shenguangmu/gesture_recognition_system/report/README.md

# 设计报告

> 本目录是赛题 §3.3.5.3「设计报告」的存放位置。

## 索引

| 文件 | 内容 | 状态 |
|---|---|---|
| [`design.md`](design.md) | **设计报告正文**（七节） | ✅ 除 §4.4 外完成 |
| [`llm-collaboration.md`](llm-collaboration.md) | **大模型协作记录**（含自我纠错轨迹） | ✅ 完成 |
| [`../src_hls/optimization-report.md`](../src_hls/optimization-report.md) | **优化对照实验 + 时序分析**（§4 的详细数据） | ✅ 完成 |

**不在本目录、但同属提交物的**：

| 内容 | 位置 |
|---|---|
| 技能包（赛题 §3.3.5.2） | [`../skill/README.md`](../skill/README.md) |
| 综合与实现报告（§3.3.5.1） | [`../vivado/build-report.md`](../vivado/build-report.md) |
| 复现说明 | 根 [`README.md`](../README.md) 的「从零构建完整工程」 |
| 目录对照说明（§3.3.5.4） | [`../docs/README.md`](../docs/README.md) |

---

## 各节状态

| 节 | 内容 | 状态 |
|---|---|---|
| ① 选题背景与创新点 | 三个创新点 + 前人工作（**含 3 篇核验过 DOI 的文献**） | ✅ |
| ② 设计原理与功能框图 | 系统总览、两条数据通路、时钟域 | ✅ |
| ③ 软硬件划分与接口 | 划分判据、唯一接口契约、96×96 重排理由 | ✅ |
| ④ 优化过程 | 实测数据 + **一次失败的优化（有数据）** + **时序分析（§4.5）** + 待补基线 | ⚠ **§4.4 缺口** |
| ⑤ 大模型协作记录 | → `llm-collaboration.md` | ✅ |
| ⑥ 技能包提炼过程 | → `../skill/README.md` | ✅ |
| ⑦ 复现说明 | → 根 `README.md` | ✅ |

---

## ⏳ 待办清单（**板已到，按此执行**）

> **影响评分的缺口只剩一个：加速比。**
> 赛题 §3.3.5.5 把"性能与资源**优化效果**"列为 **20 分**，
> §3.3.4 要求"给出**与基线的对比**"。
>
> 2026-09-18 的 B1 工作把 §4 从"单点数据"推进到了
> **"单点数据 + 一组严谨的负结果对照实验"**，
> 但**加速比这一半仍未拿到** —— 它必须在 PYNQ 的
> Cortex-A9 上测，PC 上测的数（Ryzen 9 8940HX）代际不同，不能用。

**20 分项现在的完成度**（分开说，别含糊）：

| 赛题要的 | 状态 |
|---|---|
| 资源/时序实测数据 | ✅ 有（`build-report.md`，与 `utilization.rpt` 逐项核对） |
| 优化尝试与结论 | ✅ 有（**4 组对照实验 + 探针**，且区分了"找到根因"与"能改"） |
| **上板实测性能** | ✅ **有（2026-09-21）**：预处理单帧 **≈5 ms**，11/11 全过 |
| **与基线的加速对比** | ❌ **没有 —— 唯一的真缺口，见 P1。板已到，只差跑一次** |

> ⚠ **本次上板顺带更正了一个报告里的错数**：§4.4 原写
> `crop_scale` = **20.74 ms**、整链 **21.4 ms**，那是把
> `LOOP_TRIPCOUNT` 的**循环上界**当成了实际执行拍数。
> 实为 **3.07 ms**，整链估算 ≈3.7 ms —— 与实测 5 ms 吻合。
> 详见 `design.md` §4.4 的更正框。

### P1 · PS 侧基线（**唯一能补齐 20 分项的动作**）

> ✅ **板已到、overlay 已能加载、串口与网络都已打通** ——
> 这件事现在**只需要在板上跑一次脚本**，没有任何前置阻塞。

| 步骤 | 做法 |
|---|---|
| 1 | 把 [`../host/bench_ps_baseline.py`](../host/bench_ps_baseline.py) 拷到 PYNQ（`scp` 在 **PC** 上跑） |
| 2 | 板上跑：`sudo -E /usr/local/share/pynq-venv/bin/python3 bench_ps_baseline.py --json ps.json` |
| 3 | 与 PL 侧延迟对比 → **加速比** |

> **PL 侧的口径是现成的**：`design.md` §4.4 的上板实测 **≈5 ms/帧**。
> ⚠ 对比时要说清这一项**不含摄像头采集**（输入来自 DDR 测试图），
> 以及它是 PL 侧单次预处理延迟，不是端到端帧率。

**为什么是唯一的**：它直接回答赛题的核心问题"**为什么用 FPGA**"。
其余各项（资源、时序、优化尝试）**都已经做到能做的最好**了。

**可对照的先例**：CANDAR 2020 在 **PYNQ-Z1** 上测得
"**相比同一块板的 PYNQ ARM CPU 加速 22×**"（见 `design.md` §1.4②）。
本作品测出的数可与 22× 对照。

> ⚠ **主机 CPU 的数不能直接写进报告**。该脚本在 PC 上跑出约 3.8 ms/帧，
> 但那是 Ryzen 9 8940HX，**不是 Cortex-A9**，差着代际。
> 脚本里已标注它是"主机参考值，非 PS 基线"。

> ⚠ **PL 侧那一半要取对口径**。`design.md` §4.4 的**逐级**表是
> **从 instance 表加总的估算**（顶层 `DATAFLOW` 的 latency 在 csynth 里
> 显示为 `?`，各 stage 重叠，HLS 给不出静态总延迟）。
> **权威数字是上板实测的 ≈5 ms/帧**，拿估算值去除以 PS 基线会被挑。
>
> ⚠⚠ 该表**曾经把 `crop_scale` 记成 20.74 ms / 整链 21.4 ms** ——
> 那是把 `LOOP_TRIPCOUNT` 的**循环上界**当成了实际拍数。
> **2026-09-21 上板实测更正为 3.07 ms / 整链 ≈3.7 ms**（与实测 5 ms 吻合）。
> **比加速比之前先确认这张表是当前版本**，否则会高估 PL 侧延迟一个数量级。

### P2 · 上板实测输出（**赛题硬性要求**）—— ⚠ **部分完成**

| 步骤 | 产出 | 状态 |
|---|---|---|
| 按 [`board-bringup-guide.md`](../docs/board-bringup-guide.md) 走分级验证 | — | ✅ **②③ 已过（11/11）**；④~⑧ 未通 |
| 截下 Jupyter 里出的图 | **实测输出 + 与参考结果的比对** | ✅ **已做（2026-09-23，方案 A 静态图）**：三次不同输入 / 三种 ROI，板上输出与 golden **逐字节一致**（各 0/9216）。见 [`board-test-log-2026-09-23.md`](../docs/board-test-log-2026-09-23.md) §9 |
| 测实际帧率 / DMA 吞吐 / 预处理单帧耗时 | 补进 `design.md` **§4.4** | ⚠ **部分**：预处理单帧 ≈5 ms 已测；**端到端帧率未测** |

> 赛题 §3.3.3.2："作品须**在板上跑通并提供实测输出**"。
>
> ✅ **"板上跑通"与"实测输出"两项均已达成**（2026-09-23）：
> 预处理链 11/11，且**静态图通路（方案 A）的板上输出与 golden 逐字节一致**。
>
> ⚠ **本节原先写"实测输出要等摄像头通路打通"—— 那是错的。**
> 赛题 §3.3 **没有要求必须用 DVP 摄像头**（"应用方向不限、实现方式不作限定"），
> 把图片直接写进 DDR 输入缓冲即可满足「在板上跑通并提供实测输出」。
> **摄像头是加分项，不是提交物的前置条件。**
>
> 摄像头通路本身仍未通（SCCB `cfg_error=1`），排查进展见
> [`../docs/board-test-log-2026-09-22.md`](../docs/board-test-log-2026-09-22.md) §六。
>
> ⚠ **本项原先写的是"替换 `design.md` §3.2 的『按设计推算』栏"——
> 那个引用是错的**：§3.2 是**接口契约**（buffer 位置/格式/尺寸/握手寄存器），
> 里面根本没有吞吐量推算。吞吐相关的数据在 **§4.4**。
> 已更正。

### P3 · HLS 优化前后对比 ✅ **已完成（2026-09-18）**

结果见 [`../src_hls/optimization-report.md`](../src_hls/optimization-report.md)。
**结论是负结果，但数据完整**：

- 探针证明 DSP 的根因（腐蚀流水线的索引算术：71 → 15）
- 但**改不掉**：换编译期步长无效、手写展开反而更差（71 → 86）
- **顺带查出 WNS `+0.265` 不属于本设计**，是 AMD `v_tc` IP 的
- **顺带核对出 3 处凭记忆写错的资源数字**（LUT `13,184`→`13,144`、
  Fmax `137`→`143.31 MHz`），已更正
- 工具用上了：[`../skill/pynq/golden_compare.py`](../skill/pynq/golden_compare.py)，
  同时**发现并修掉了它的一个静默失败**（见 `skill/pynq/README.md`）

> ⚠ **DSP 的大头在 `morph_stage`（56 个），不在 `thresh_stage`（2 个）。**
> 项目里曾有四处写反。
>
> ⚠ **旧警告已作废**：这里原先写"唯一能降 DSP 的改法会让 II 从 1 退化成 2"。
> 经 2026-09-18 实测，**从未出现过 II=2**（全程 II=1），
> 而能降 DSP 的写法代价是**资源反而增加**（71→86）。详见 `optimization-report.md`。

### P4 · 上电前的硬件复核 —— ⚠ **引脚复核仍未做**

| 项 | 为什么 | 状态 |
|---|---|---|
| **引脚万用表复核** | XDC 映射是**推理**的（原理图"镜像编号"），**插错会 3V3/GND 反接烧板**（步骤见 `board-bringup-guide.md` §2.2） | ❌ **仍未做**（上电前应做但跳过了）—— 见 `board-bringup-guide.md` §2.2 |
| 短路检查 | 3V3 对 GND 的电阻 | ✅ 已做 |
| **OV5640 出图验证** | 配置表已换 250 条真表 | ⚠ **上板确认事务发出但无 ACK**（`cfg_error=1`），未出图 |

> ⚠⚠ **引脚复核与本项目当前故障直接相关**：摄像头 SDA/SCL 的引脚映射是
> 按"镜像编号"**推理**的，从没实测过。而 ILA 抓到的 `sccb_0/cfg_error=1`
> （配置无 ACK）正是"接线错"的典型症状之一。
> **它同时也是唯一有烧板风险的一项**，应尽快补做。
