shenguangmu/gesture_recognition_system/docs/images/roi_compare.png

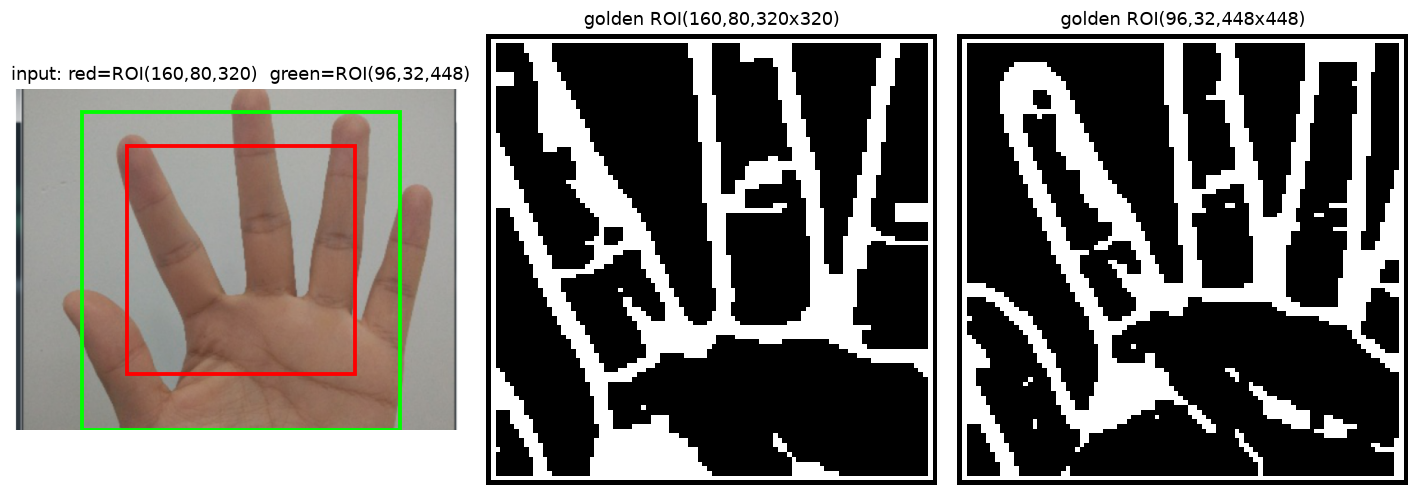
docs/images/roi_compare.png
