shenguangmu/gesture_recognition_system/docs/images/board-test-input-2026-09-23.png

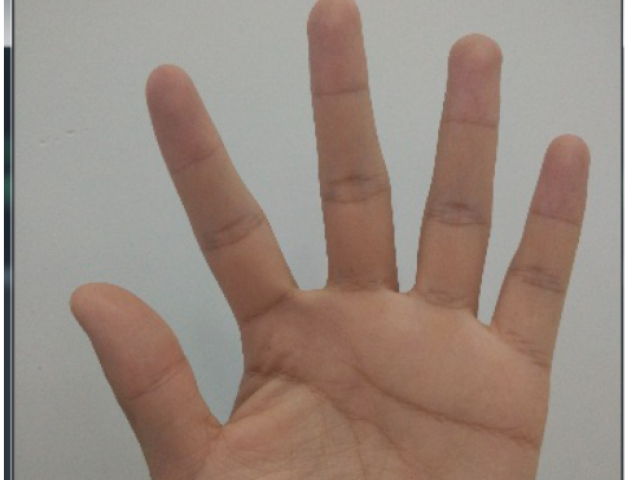
docs/images/board-test-input-2026-09-23.png
