shenguangmu/gesture_recognition_system/(commit log)

2026-09-20 修一个被截断的函数 + UTF-8 兜底去重，然后打板前锚点 tag
    ## 修的是我自己几轮前写的 bug（**它在 HEAD 里已经躺了多个提交**）
    `host/bringup_check.py` 的 `step2_ddr()` 被**从中间截断**：
    def _fail(): # 第 101 行 —— 插在了 step2_ddr 中间
    return False
    import numpy as np # ← 后面全是死代码
    buf = allocate(...) # step2_ddr 的剩余部分，永远执行不到
    我当时把 `_fail()` 的定义插进了 `step2_ddr()` 里头。
    **为什么一直没暴露**：测试跑的是 `--step 2`，在无板环境下
    `from pynq import allocate` 必然失败，走早退分支 `return _fail()`
    ——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
    [bringup_check.py, pynq_serial.py, test_overlay_offline.py, test_pynq_serial.py]
2026-09-20 修 pyserial 的模块级硬退出 + 让"跳过"可见（CI 抓到的两个问题）
    ## ① `pynq_serial.py` 在 import 时就 sys.exit(2)
    CI 首次跑新加的 job 就红了，退出码 2：
    `需要 pyserial： pip install --user pyserial`
    后果不只是 CI：**连它自己的离线自检都跑不起来** ——
    `test_pynq_serial.py` import 本模块时就被那个 exit 带走，
    而离线自检要测的 `_pick_ips` 是**纯正则，根本不需要 pyserial**。
    改成"用到串口时才报错"（`_need_serial()`）：
    库的部分可以无依赖地 import 和测试。
    ## ② 测试**静默跳过**，汇总照样报 PASSED ← 更值得记的一条
    给跳过加了计数器之后，汇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
    [pynq_serial.py, test_pynq_serial.py]
2026-09-20 修 CI 检查自身的误报："跳过"二字命中了小节标题
    上一提交加的"不许有跳过"检查：
    if grep -q '跳过' /tmp/serial.log; then exit 1; fi
    结果 [2] 的小节标题 **「串口筛选（跳过蓝牙幻影口）」** 把它命中了 ——
    日志明明是 `PYNQ_SERIAL TESTS PASSED (10 项)`，却报了
    `::error::有测试项被跳过 —— 覆盖不完整`。
    **这是我这一轮第三次被自己新加的检查绊倒**（前两次是
    正则误伤 bringup_check.py、以及跳过分支没计数）。
    规律很清楚：**"检查"本身也是代码，也会错，而且错了更难发现 ——
    因为它在报错，看起来像是在工作。**
    改法：
    - 跳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
    [test_pynq_serial.py]
2026-09-20 手册加 §6.5「现象 → 先查哪」——把脚本里的排查提示系统化补进文档
    ## 动机
    §5 的每一步都写了「**应该看到什么**」，但上板时人手里只有现象、
    没有结论。而 `host/bringup_check.py` 的失败分支里其实已经写好了
    一堆排查提示 —— **那些只活在脚本里，文档里没有**。
    对齐了两边，缺口有 3 类共 8 条：
    | 脚本里查了 | 手册原来有没有 |
    |---|---|
    | 回读是 248 而非 -8 | ❌ |
    | 卡在等 ap_done 超时（3 条） | ❌ |
    | 输出**全黑**（3 条） | ❌ |
    | 输出**全白**（2 条） | ❌ |
    | 串口卡 Loading kernel | ✅（§9） |
    | io_xclk / io_pclk 无波形 | ✅（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
2026-09-21 修 AXI DMA 长度位宽 14→24，解决上板 ③ 卡死（首次上板实测）
    根因：bd_video.tcl 例化两个 AXI DMA 时**没设 C_SG_LENGTH_WIDTH**，
    IP 用默认值 14 位 → 单次传输上限 2^14-1 = 16383 字节。
    而输入帧是 614400 字节（640x480 RGB565），是上限的 37 倍
    → DMA 只搬了前 16 KB 就置 IOC_Irq（"传输完成"是真的，
    只是它认为的"全部"只有 16 KB）
    → crop_scale 永远读不满输入 → 整条 DATAFLOW 链停摆
    → dst 不吐 → ap_done 永不置位。
    确诊证据：写 LENGTH 614400 → 读回 8192
    （= 614400 mod 16384，完全吻合；写一组值验证了 123456→8768、
    100000→1696、65536→0，规律一致）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
2026-09-22 把 2026-09-21 首次上板实测的结论同步到全部文档
    上一轮（a4eabe6）只记了代码修复与一份实测记录，各 README / 报告
    仍停在"板子未到"的状态。本次按 skill/self-correction 模式 4
    （按完备范围检查，不按记忆范围）枚举全部 git ls-files '*.md'，
    逐一核对并同步。
    同步内容：
    - 板级状态：②③ 通过（11/11，单帧 ≈5ms）；④~⑧ 未通（SCCB cfg_error=1）
    - 上板命令改为正确的 sudo -E + 解释器全路径形式
    - 坑计数 19→20（vivado/README 新增坑 20 = pitfalls P10 = DMA 长度位宽）
    - host/README 补全漏列的 5 个上板诊断脚本
    - skill/README 的 pitfalls 计数 8→10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
2026-09-22 修 MMCM 参数失效 + 引脚映射全错（第二轮上板实测）
    摄像头通路仍未打通，但查清并修复了两个独立根因，
    两者都是"综合能过、只有上板才暴露"的类型。
    ## 根因一：MMCM 参数被静默忽略（XCLK 因此不出）
    bd_video.tcl 里设的 MMCM_CLKFBOUT_MULT_F 等三个参数被丢弃：
    WARNING: [IP_Flow 19-3374] An attempt to modify the value of
    disabled parameter 'MMCM_CLKFBOUT_MULT_F' ... has been ignored
    只给 WARNING 不给 ERROR，工具照用自己的求解器结果（自选 VCO≈1005MHz，
    贴着 -1 速度等级上限）。
    解药是 CONFIG.OVERRIDE_MMCM {true} —— 不是 PRIMITIVE {MMCM}，
    也不是 USE_FREQ_SYN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
    [camera_probe.py, vdma_bypass_test.py, video_io.xdc]
2026-09-22 建立静态图输入通路（方案A）+ 发现 crop_scale 整数块平均缺陷
    摄像头仍未通，但改走"静态图喂 DDR"后主线跑通，
    并因此暴露出一个此前从未触发的 PL 算法 bug。
    ## 方案 A：图片直接写进 DDR，完全跳过摄像头
    读过赛题原文（AMD.pdf §3.3 自主选题赛道·初级组）：
    - "应用方向不限"、"实现方式不作限定"
    - 硬性要求只有"板上跑通并提供实测输出"+"与基线对比"
    通篇没有"必须用 DVP 摄像头"的要求。备赛分析报告也把 USB 摄像头
    列为可选图像源。故方案 A 在规则上完全站得住。
    新增 host/capture_frame.py：图片/USB摄像头 → 640×480 RGB565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
    [capture_frame.py]
2026-09-23 修 crop_scale 固定步长缺陷：改按比例分配
    根因：旧实现 step = ceil(roi_w/96)，roi_w=320 时 step=4 恰好整除
    → 每行只吐 320/4 = 80 个输出 → 只填 80×80=6400，剩 2816 个走补零
    → 输出右下角一大片恒为零。这正是 2026-09-22 "静态图对拍 golden
    对不上"的根因，与摄像头无关。
    ⚠ 为什么藏了这么久：HLS / C++ golden / Python golden 三份实现
    **用了同一套错误逻辑**，csim 是自比对 → 两边一起错 → 永远"通过"。
    N 份实现 ≠ N 份独立验证，抄语义不算对拍。
    修法：按比例分配。第 j 个输出覆盖源 [j*roi_w/96, (j+1)*roi_w/96)
    （整除）。相邻区间共用同一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
2026-09-23 修 GesturePipeline 构造：Overlay() 必须显式传 bitfile
    板子上第一次调用就炸：
    TypeError: Overlay.__init__() missing 1 required positional
    argument: 'bitfile_name'
    根因：PYNQ 3.x 的签名是
    Overlay(bitfile_name, dtbo=None, download=True, ...)
    bitfile_name 是**必填位置参数**，没有默认值；而 notebook 里
    `Overlay()` 能自动找同名文件是 PYNQ 的语法糖，**类构造器没有这个行为**。
    我们写的 `Overlay(**kw)` 传不出 bitfile_name。
    修法：bitfile 为 None 时自己解析路径（新增 _find_bitfile()），
    再显式传给 Overlay。查找优先约定名 gesture_system.bit，
    退化到"目录里唯一的 .bit"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
    [gesture_overlay.py, test_overlay_offline.py]
2026-09-23 修 crop_scale 跳过 ROI 外行时不读流 → roi_y 完全失效
    上板实测（2026-09-23）：寄存器 roi_y 读回 80/160 均正确，
    但硬件行为恒等于 roi_y=0：
    配 roi_y=80 与 roi_y=160 → 输出**逐字节相同**
    且都 == golden(roi_y=0)
    根因：crop_scale 的行循环
    for (y) {
    if (!(y>=roi_y && y<roi_y+roi_h)) continue; // ← 整行跳过
    for (x) { w_in = src.read(); ... } // ← 流在这里读
    }
    跳过的行**一个像素都没从流里读走** → 上游数据没被消费 →
    硬件把**帧的前 roi_y 行**当成了 ROI 首行。
    （roi_x 不走这条路 —— x 循环不跳过、in_roi 只做判断、照常 rea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
2026-09-23 更新上板日志：追加 roi_y 失效 bug 的根因与验证
2026-09-23 上板日志 §2 标注：最终用 §8.5 那版（roi_y 修复后）
2026-09-23 上板日志：真实照片 + 合成图三次测试全部逐字节一致
    - §9 记录用真实照片（力手）走完整静态图通路，两种 ROI 均与 golden 100% 一致
    - §9.3 ROI 选点经验：roi_x=160 会把拇指切出框外，roi_x 需 <=100 才纳入五指
    - §9.4/§9.5 新增原生 640x480 合成手势图全幅测试，三次测试汇总
    - 新增 docs/images/ 对比图 4 张
    - 新增 host/run_static_frame_on_board.py（板端跑帧 + 对拍脚本）
2026-09-23 修正对比图：测试1 的 golden 用错了文件
    生成 all_tests_compare.png 时，通用名 golden.bin 已被
    合成图的全幅 golden 覆盖（cp golden_448.bin golden.bin 后又
    cp synth_golden.bin golden.bin），导致测试 1 那一行拿
    "力手 160,80 的输出" 去比 "合成图 0,0 的 golden"，
    图上误显示 FAIL 3594。
    实际上该次板上实测是 0/9216 一致。现已用单独命名的文件
    （force_r1_golden.bin / force_r2_golden.bin / synth_golden.bin）
    重新生成，并新增「差异图」一列（全黑=完全一致）便于自验。
    三者逐一核对：
    测试1 板上2677 / golden2677 差异 0
    测试2 板上2806 / golden2806 差异 0
    测试3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
2026-09-23 README 补一键重建 + 今日四坑；rebuild_all.sh 加僵死进程防呆
    README：
    - 新增「⭐ 推荐：一键重建」段，说明为什么不能手敲那两条命令
    （IP 版本号永远是 1.0 → 取了旧 IP 也不报错，只会默默用错实现）
    - 补 .hwh 必须改名成 gesture_system.hwh 的警告
    （名字不一致时 PYNQ 不报"找不到 hwh"，而是只认出 default 一个 IP）
    - 「最值钱的坑」表加今日四条：跳过 ROI 外行不读流、IP 版本号恒 1.0、
    Overlay 构造器要显式传 bitfile、ILA 会让正式比特流 hold 违例
    - 新增「这些坑背后的同一个模式」小节：一天内三次"测试全绿却有缺陷"，
    分别因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
2026-09-23 同步各 README 到 2026-09-23 的实际状态
    今日两个真缺陷已修，多处 README 的描述过期：
    src_hls/README.md
    - 顶部清单与验证表：csim 用例 5 → **7**、cosim 6/6 → **10/10**
    - 板级输出 vs golden：❌ 对不上 → ✅ **逐字节一致**（三次实测各 0/9216）
    - 原「⚠⚠ 已知 bug：填不满 96」→ **✅ 已修**，并补上第二个缺陷
    （跳过 ROI 外行不读流 → roi_y 失效）
    - ⚠ 删掉一条**已证伪的判断**：本文件曾写"Python golden 走浮点比例缩放、
    与整数块平均语义本就不同"—— 实际它当时也照抄了固定步长，
    这正是三份实现一起错、csim 永远通过的原因
    -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
2026-09-23 更新 LUT 资源数字到 2026-09-23 实测（21% → 45.94%）
    crop_scale 改按比例分配后，需要 acc[96] 累加器 + ARRAY_PARTITION
    complete 才能保住主循环 II=1，LUT/FF 接近翻倍。**是设计变更，不是测量误差。**
    源头（vivado/build-report.md，赛题 §3.3.5.1 要求提交的那份）：
    Slice LUTs 11,255 (21.16%) → **24,442 (45.94%)**
    Slice Registers 14,810 (13.92%) → **30,692 (28.85%)**
    WNS +0.265 → **+0.199**（仍属 v_tc 内部，非本设计余量）
    BRAM 18.21% / DSP 27.73% / IOB 28.00% —— **三项不变**
    新增「LUT/FF 翻倍是设计变更」小节，附新旧对照与取舍理由、
    以及回退方式（去掉 acc[] 的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
2026-09-23 README/文档补状态：静态图通路已验证，不再是"卡在摄像头"
    用户的观察是对的：上一轮我只查了**数字**，没查**状态描述**，
    而后者误导性更强。系统性重查后修掉这些：
    根 README.md（总入口，误导性最强）
    - 进度表标题：2026-09-22 → **2026-09-23**
    - 输出 vs golden：❌"对不上…**明天修**" → ✅✅ **逐字节一致**（三次实测）
    - 静态图喂入：补"与 golden 逐字节一致"
    - 时序：WNS +0.517 → **+0.199**（2026-09-23）
    - 驱动自检 24/24 → **26/26**
    - 上板必读：补 09-23 日志；WNS 波动值补 +0.199
    - 结论段：不再说"下一步用 ILA 探针"，改为**⚠ 别用 ILA*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
2026-09-23 交付第一步：修正给 PS 侧的接口契约 + 备好样例数据
    ⚠⚠ 修掉一个**会直接坑死 PS 侧**的错误契约：
    docs/architecture-contract.md §3.2 原先描述了一套"握手寄存器"
    （INPUT_ADDR / FRAME_SEQ / frame_ready / CTRL.capture_start）——
    **那套寄存器从未实现**，BD 与 RTL 里 grep 只有一句注释。
    照那份假契约写代码必然跑不通。
    §3.2 改写为**已实现的真实接口**：
    - 三个 IP 及其 AXI-Lite 基地址（并警告别硬编码，重综合后会变）
    - gesture_preproc 全部 16 个寄存器偏移（与 HLS 官方头逐条核对过）
    - ⚠ 状态位在 CTRL(0x00) bit1，**不在 0x04**（那是 GIE）
    - ⚠ thre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
2026-09-23 samples: 补 thresh_mode 二值/灰度对比 —— 决定 CNN 能学什么
2026-09-23 samples: 修掉文档里被吃掉的续行符
2026-09-23 新增给 PS/CNN 侧的交付说明 docs/pl-to-ps-handoff.md
    一份可独立阅读、可直接发给对方的文档。核心信息：
    **PS 侧现在就能开始，大部分工作不需要板子**
    - 数据格式：96×96 uint8 行优先，9216 B，4 字节对齐，不归一化
    - 批量造数据：host/gesture_golden.py 可 import，
    输出与硬件**逐位一致**（三方对齐链：板上 == C++ golden == Python golden）
    - samples/ 里有硬件实测对过的 golden（md5 与板上输出相同）
    **⚠ 一处必须先在 PS 侧拍板的事：thresh_mode**
    1（当前默认）→ 二值（只有 0/255），对光照天然鲁棒
    0 → 灰度（99 种取值），保留边缘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
2026-09-23 新增 host/usb_camera_run.py —— USB(UVC) 摄像头 → PL 预处理链
    USB 摄像头是另一条输入路径，绕开全部 DVP 硬件：
    USB: 摄像头 --USB--> PS CPU --> DDR --> PL(dma_in) --> 预处理链 --> DDR
    ↑ 从"写进 DDR"起，与方案 A 完全相同
    **PL 侧一行都不用改** —— 这正是把边界定成「DDR 里一块 640×480 RGB565」的价值。
    ⚠⚠ 脚本里最关键的一行是强制 MJPEG：
    PYNQ-Z2 是 USB2。720p 下 YUYV 需 ~55 MB/s（超 USB2 实际带宽），
    MJPEG 只用 3~6 MB/s。不设 FOURCC 时 UVC 默认常协商成 YUYV →
    **分辨率被悄悄降级或帧率掉到个位数，且不报任何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
2026-09-23 host/README 索引补 usb_camera_run.py
2026-09-23 新增 host/run.py —— 板上日常操作的一键入口
    把上电后要敲的那一长串（chdir / import / 加载 overlay / 配 ROI /
    读 bin / flush / run_once / show）收敛成一句：
    %run /home/xilinx/run.py
    设计取向：**只做基本操作和输出，不做断言**。
    判定/校验交给 bringup_check.py；这个是干活用的 —— 跑一次、看一眼、走人。
    交互式菜单列出当前可用的输入（按修改时间倒序）：
    · *.bin（已有的测试帧）
    · 图片（jpg/png/...，自动缩放 + 转 RGB565）
    · USB 摄像头（货到即可用）
    · 手动输入路径
    ⚠ 刻意不用 argparse：`%run x.py --frames 3` 时 IPython 会把参数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
2026-09-23 板上首跑 run.py 踩的两个问题：菜单混入输出文件 / 中文标题豆腐块
    都是 2026-09-23 板上实跑发现的。
    run.py —— 菜单按**大小**过滤
    /home/xilinx/ 下同时躺着两类 .bin，后缀一样、名字分不出：
    输入帧 640x480 RGB565 = 614400 字节
    输出结果 96x96 灰度 = 9216 字节
    而**输出文件的数量是输入的 6 倍**，按修改时间倒序排，
    菜单第一项必然是输出 —— 也就是**任何人第一次用都会踩**。
    实测选中 hw_synth.bin（9216 B）当输入，以"字节数不对"结束。
    改为按大小分流，并明确列出"以下不当作输入（尺寸不符）"及原因 ——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
    [gesture_overlay.py, run.py]
2026-09-23 纳入板上调试脚本：ap_done_probe / ap_start_probe / dma_diag
    这三个一直只存在于板上，仓库里没有 —— 清理板子前先把它们收进版本库，
    否则里面的经验会随文件一起丢。都是 2026-09-21 排查 ap_done 超时时留下的：
    - `dma_diag.py` —— 查 dma_in/dma_out 卡在哪。**v2 修正了 v1 的两个错误**：
    ① v1 把 DMASR 的 bit1(IDLE) 当成 IOC → "IDLE=0" 被误读成"在忙"
    ② v1 在轮询循环里边读 CTRL 边判 → 读到的 0 不能证明"没跑完"
    v2 改成：轮询时**不读 CTRL**，只读 DMASR；循环后再取一次快照
    - `ap_done_probe.py` —— 因为 v1/v2 都在"怎么解读 DMA 状态寄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
    [ap_done_probe.py, ap_start_probe.py, dma_diag.py]
2026-09-23 host/README：补三个诊断脚本 + 清理板子的检查清单
    一、诊断脚本表更新
    之前写着「`ap_done_probe.py`、`dma_diag.py` 没进仓库，
    要复现那一步得照实测记录重写」—— **现在有了**，而且漏说了 `ap_start_probe.py`。
    顺带把这三个的来历说清楚 —— 它们是"反过来做"的产物：
    `dma_diag` 的 v1/v2 **都在"怎么解读 DMA 状态寄存器"上出错**
    （v1 把 DMASR 的 bit1(IDLE) 当成 IOC；v2 修正为轮询时不读 CTRL）
    `ap_done_probe` 就是因为这两版都不可信才写的 ——
    **干脆不解读状态位**，只测两个硬事实（ap_done 何时置位 / DMA 搬没搬）
    >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
2026-09-24 docs(hls): 更正 gesture_preproc.h 的失效说明与 6 个零实现声明
    纯注释改动，无语义变化。csim 7/7 通过（含两个历史 bug 的回归用例）。
    - 文件头：共享清单里的 `sw/gesture_driver.h` **在本仓库从未存在**
    （实际是 sw/preproc_driver.h，且它并不 include 本头文件，只同步常量）。
    "四处共享"改为三处并说明 PS 侧是常量同步关系而非 include。
    - 文件头：处理链图原画成 "rgb2gray → ... → morph_close → roi_extract"，
    与实现**方向相反**。实际是 crop_scale 打头、几何处理在最前
    （见 gesture_preproc.cpp 文件头「处理链」一节：省 33 倍算力的关键设计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
    [gesture_preproc.cpp, gesture_preproc.h]
2026-09-24 feat(host): 新增 auto_roi.py —— 自动跟随手部的 ROI 估算（方案 B）
    背景：`gesture_preproc` 的 ROI 是 PS 写死的四个常量，PL 完全不知道手在哪。
    2026-09-23 实测：ROI=(160,80)320x320 把拇指切出框外，输出只剩四根手指。
    本模块在 ap_start 之前，从 DDR 整帧估算手的位置，再写 ROI 寄存器。
    方案 B（用户选定）：尺寸恒定 448x448，中心跟手，钳到画面内，
    前景太少则回退居中。尺寸恒定是为了保持 crop_scale 缩放比不变、
    Sobel 的 gain=256 标定一直有效。
    检测算法：前景 = |Y - bg| > 25，bg 取画面边框像素的中位数。
    - 用**绝对偏离**而非 "Y > 阈值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
2026-09-24 feat(sccb)+docs: SCCB 失败定位、修正假握手表、修正"局部均值"注释
    三件事，各自独立验证。
    ═══ ① SCCB 失败定位（rtl/sccb_master.v + tb）═══
    摄像头调试卡在 cfg_error=1，但**无法回答最关键的二分问题**：
    第 1 条就 NACK → 总线层（上拉/接线/器件地址/电源）
    中间某条 NACK → 该条寄存器值不被接受
    两者排查方向完全相反，而在改动前它们**长得一模一样**：
    cfg_error=1、done_cnt=250、cfg_done=1。
    （done_cnt 是**事务计数**，遇到 NACK 也照样递增 —— 所以
    "全都成功"和"全都失败"在旧探针上无法区分。）
    新增两个输出端口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
    [gesture_preproc.h, sccb_master.v, tb_sccb_master.v]
2026-09-25 build: 重建 —— xsa 纳入 9/24 的 SCCB 诊断探针，比特流可上板
    背景：上一次重建在 impl_1 启动后就断了，全盘没有 .bit，
    仓库里唯一的比特流是 9/23 打进 xsa 的那份，**不含** 9/24 的改动。
    9/24 对 src_hls/gesture_preproc.h 的注释级改动也从未过一次综合。
    本次重建（2026-09-25，tools/rebuild_all.sh 全程通过）：
    HLS csim PASSED，全部循环 II=1
    IP 指纹 0fa621b8cc407319 → 57f4c554c93bfb81（说明改动确实传导进了 IP）
    csynth 全设计 Est. Fmax 122.95 MHz（morph_stage 阶段 143.31 MHz）
    Vivado WNS +0.198 / WHS +0.051 ns，DRC 0 Errors
    use_ila=0（BRAM 18.21%，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
2026-09-25 fix(host): print_info 用 phys_addr —— 键名 base_addr 是 PYNQ 2.x 的
    2026-09-25 上板（板载 PYNQ 3.0.1）实测发现：
    `print_info()` 打印的 6 个 IP 地址**全部是 0x00000000**。
    根因：`self.ol.ip_dict` 里地址的键名是 `phys_addr`（见
    /usr/local/share/pynq-venv/.../pynq/overlay.py:257 的文档字符串），
    而本文件写的是 `base_addr` —— 那是 PYNQ 2.x 的名字。
    `.get('base_addr', 0)` 取不到就回落成 0，**不报任何错**。
    危害：排查 IP 认不到时会误判成"IP 没映射到地址空间"，
    方向完全错。
    修复：改用 `phys_addr`，并注释记下这个键名坑。
    离线自检 host/test_overlay_offline.py 70/70 仍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
    [gesture_overlay.py]
2026-09-25 docs: 新增 board-cheatsheet.md —— 板上常用操作速查
    补充现有文档的空白：board-bringup-guide.md 讲的是「第一次上板怎么通」，
    但没有一处集中回答日常操作问题 —— 传文件在哪边敲、图片怎么变成
    板子认的格式、Jupyter 里那串固定代码是什么。
    本文件覆盖：
    · PC ↔ 板子 传文件（scp / Jupyter 网页上传 / SFTP / HTTP），
    含「命令在哪边跑」的对照表（最容易搞错的一条）
    · 传「图片」的完整流程 —— 重点是「板子不认 jpg/png，
    必须先转成 640×480 RGB565 裸 .bin」这个契约
    · ⚠ ROI 三处必须一致（生成 golden / 板上 config / 原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
2026-09-25 docs(auto_roi): 换掉错误的论证 + 补 ROI 尺寸实测扫描 + 记录"小臂污染"缺陷
    三件事，都由 2026-09-25 的参数扫描测得。
    ═══ ① 更正「为什么 ROI 必须是正方形」的理由 ═══
    原文写的理由是「尺寸恒定 → 缩放比恒定 → gain 标定一直有效」。
    真正的理由是 **crop_scale 对 x/y 独立缩放**（host/gesture_golden.py，
    HLS 侧同公式）：
    xs = (arange(97) * roi_w) // 96
    ys = (arange(97) * roi_h) // 96 → 输出恒 96x96
    所以手的输出宽高比 = (手_w/手_h) × (roi_h/roi_w)，
    **roi_w != roi_h 会把手形拉伸变形**。这才是不正方形的真正代价。
    结论（必须正方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
2026-09-25 fix(host): run.py 默认 ROI 320 -> 448，与 auto_roi 的建议对齐
    背景：现在两个工具会给出**互相矛盾**的建议 ——
    run.py 回车用默认 -> 320x320
    auto_roi.py --print-config -> 448x448
    按了回车就切到手。
    2026-09-24 auto_roi 实测：固定 320 会把「合成手势图」的上下各切掉
    约 35 px（那张的手本身就 391 高 > 320）。所以 448 才是该默认的那个。
    ═══ 只改 run.py，**没有**去改另外三处 320 ═══
    320 一共出现在 5 个地方，但它们服务两个不同目的：
    run.py <- 日常跑，要看手 -> 改
    auto_roi.py <- 跟手方案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
    [auto_roi.py, run.py]
2026-09-25 feat(host): 新增 push.py —— 推文件/图片上板，一步到位
    `scp` 能传文件，但**传图片**每次要记三步：先转 RGB565 .bin、
    再算配套 golden、还要保证 ROI 三处一致；而且不核 md5。
    push.py 把这几件事一起做了：
    python host/push.py 手.jpg # 转 + 配 golden + 传 + 核 md5
    python host/push.py 手.jpg --roi 160 80 320 320
    python host/push.py 固件.bit host/run.py # 任意文件裸传
    python host/push.py -r host/ # 目录
    python host/push.py 手.jpg --dry-run # 只看会做什么
    为什么值得有个脚本（每条都是踩过的）：
    · ⚠ **板子不认 jpg/png**。忘了转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
2026-09-25 feat(push): 显式报告图片会被裁掉多少 + 修 subprocess 的 GBK 解码崩溃
    起因：问"传别的图片呢"。实测几种常见宽高比，发现裁剪量**完全静默**。
    ═══ ① 裁剪是静默的，现在会明说 ═══
    转换走的是 **cover**（按比例缩放到填满，再居中裁剪），所以裁掉多少
    **只取决于宽高比**。而转出来的 .bin 永远"尺寸正确"（614400 字节），
    **不会给任何提示**。实测：
    16:9 手机横向 1920x1080 → 左右各裁 12.5%，共 25% 宽度
    4:3 相机 1600x1200 → 不裁
    3:2 单反 3000x2000 → 左右各裁 5.6%，共 11% 宽度
    1:1 方图 1000x1000 →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
2026-09-25 docs: 新增 HANDOFF.md —— 交接说明，一页回答「从哪开始」
    背景：仓库有 150 个跟踪文件、10 份 docs、每个子目录还有自己的 README。
    队友拿到后没有入口，容易迷路。根 README 已经很长（讲的是技术细节），
    缺一份「你先看这个」。
    结构按「你现在想干什么」分三条路：
    🅰 跑比特流 / 上板 → tools/rebuild_all.sh（需 Vivado 2025.2 license）
    🅱 调 CNN / 做 PS 侧 → samples/ + gesture_golden.py（**不需要板子**）
    🅲 改代码 → 先读 architecture-contract.md + 改哪里要同步改哪里
    另含：
    · §零 不需要 license 就能跑的三条验证命令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
2026-09-26 feat(host)+docs: 新增 roi_analysis.py；更正 auto_roi 的一条错误结论
    ═══ ① 先更正：之前有一条结论是错的 ═══
    上一轮分析得出过「ROI 跟随让位置噪声从 19.7% 涨到 31.1%，跟随是坏的」。
    **那个结论错了，是测试方法造的假象。**
    错因：用平移**整幅图**来模拟"手在动"，空出来的边是纯黑（Y=0），
    而前景判据 `|Y-bg| > 25` —— 黑边自己就满足 `|0-32| = 32 > 25`，
    于是黑边被判成前景、bbox 铺满画面、中心乱跑。
    正确做法：用**手部 mask 抠出手、贴到同一张背景板的不同位置**（背景不动）。
    实测（修正后）：
    手位移 dx bg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
    [auto_roi.py, roi_analysis.py]
